raffreddat0/chessmaster/public/chessmaster-board.png

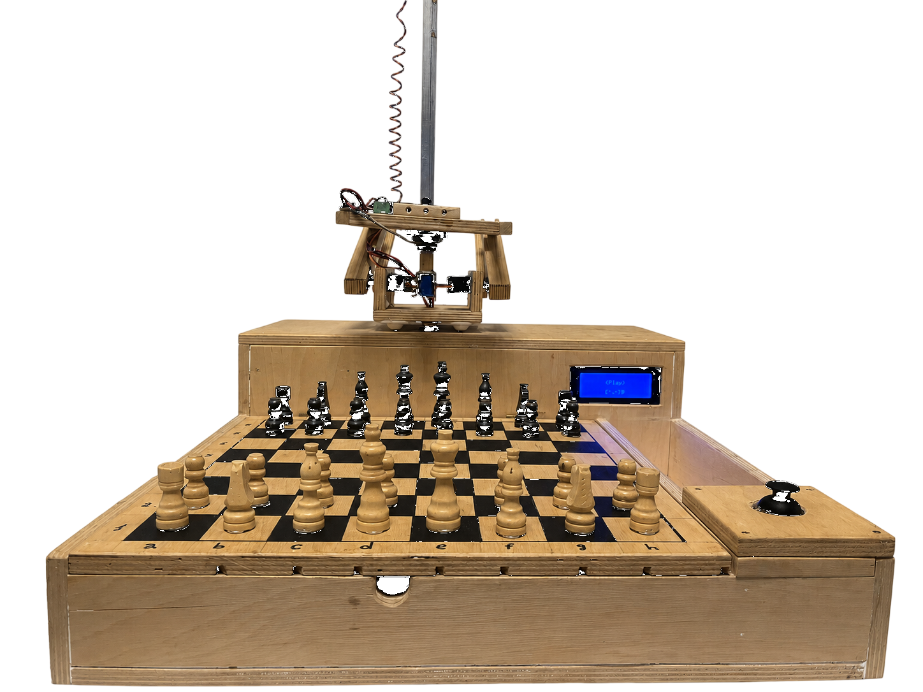
public/chessmaster-board.png
