raffreddat0/chessmaster/public/chessmaster-arm.png

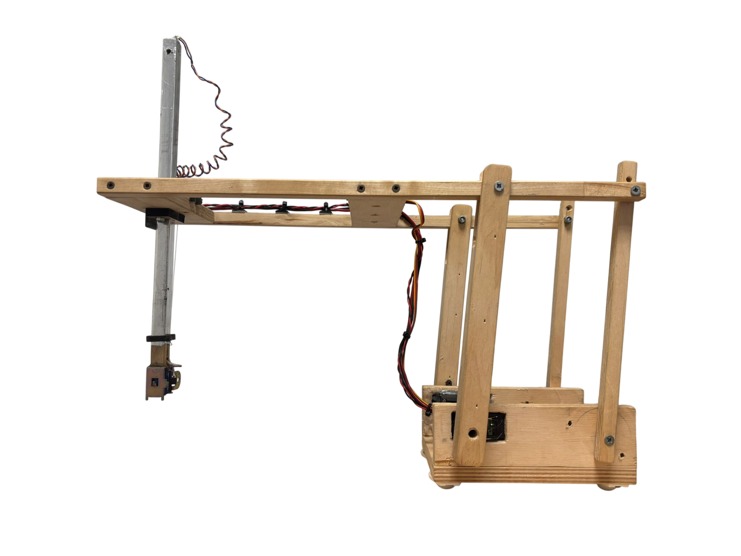
public/chessmaster-arm.png
