raffreddat0/chessmaster/public/frankie.png

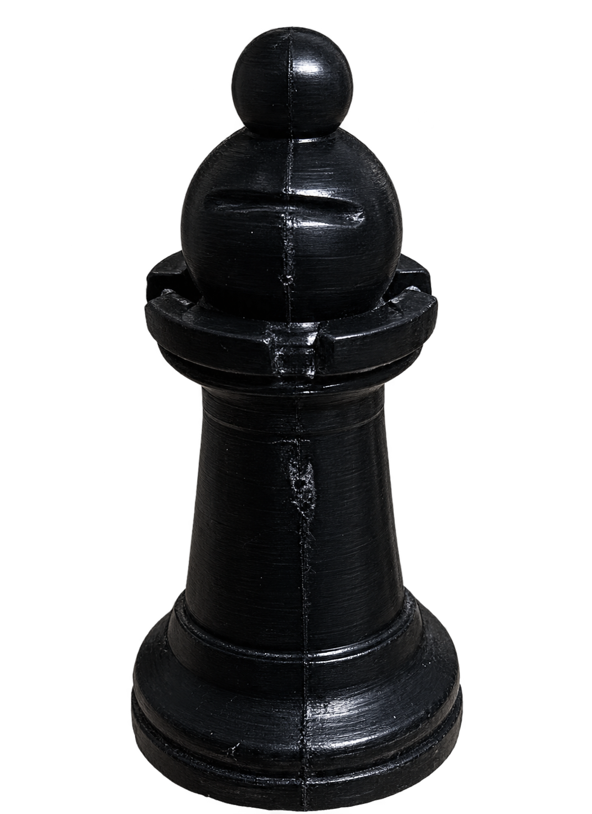
public/frankie.png
