raffreddat0/chessmaster/arduino/mega/mega.ino

#include "menu.h"

int M[cell][cell], M0[cell][cell];
char position[5] = "";
int moved[2] = {0, 0};
int invalid[2] = {-1, -1};
int t = 0;

void setup() {
  Serial.begin(9600);
  Serial1.begin(9600);
  lcdbegin();
  serbegin();

  for (int i = 0; i < cell; i++) {
    pinMode(cols[i], OUTPUT);
    pinMode(rows[i], INPUT_PULLUP);
  }

  for (int row = 0; row < cell; row++) {
    for (int col = 0; col < cell; col++) {
      for (int i = 0; i < cell; i++)
        digitalWrite(cols[i], LOW);

      digitalWrite(cols[col], HIGH);
      M[row][col] = M0[row][col] = digitalRead(rows[row]);
    }
  }
}

void loop() {
  int playing = lcdloop(M, t, position, invalid);
  serloop();

  if (ddlay(500)) {
    //Serial.print("\n\n\n");
    for (int row = 0; row < cell; row++) {
      for (int col = 0; col < cell; col++) {
        for (int i = 0; i < cell; i++)
          digitalWrite(cols[i], LOW);

        digitalWrite(cols[col], HIGH);
        M[row][col] = digitalRead(rows[row]);
        if (M[row][col] != M0[row][col] && M0[row][col] == 1 && t == 0) {
          position[0] = char('a' + col);
          position[1] = char('1' + 7 - row);
          position[2] = '\0';
          position[3] = '\0';
          position[4] = '\0';
          moved[0] = 1;
          moved[1] = 0;
        }

        if (M[row][col] != M0[row][col] && M0[row][col] == 0 && moved[0] == 1 && t == 0) {
          position[2] = char('a' + col);
          position[3] = char('1' + 7 - row);
          position[4] = '\0';
          moved[1] = 1;
        }

        M0[row][col] = M[row][col];
        //Serial.print(M[row][col]);
      }
      //Serial.print("\n");
    }
  }

  if (moved[0] == 1 && invalid[0] != -1 && invalid[1] != -1) {
    invalid[0] = -1;
    invalid[1] = -1;
  }

  if (moved[0] == 1 && moved[1] == 1) {
    if (playing == 1 && (position[0] != position[2] || position[1] != position[3]) && t == 0) {
      // Serial.println(String(position));
      Serial1.println(String("move ") + String(position));
    } else {
      strcpy(position, "");
    }

    moved[0] = 0;
    moved[1] = 0;
  }
}
