raffreddat0/chessmaster/arduino/mega/servo.h

#include <Servo.h>
#include "pins.h"

Servo servo1;
Servo servo2;
Servo servo3;
Servo servo4;

float dwn = 0;

struct Square {
  int turn;
  int move;
  int down;
};

extern Square S0 = {};
extern Square S[8][8] = {};

void serbegin() {
  Serial.begin(9600);

  pinMode(pinMagnet, LOW);
  pinMode(pinBreakOutput, OUTPUT);
  digitalWrite(pinBreakOutput, HIGH);
  pinMode(pinBreak, INPUT_PULLUP);

  servo1.detach();
  servo2.detach();
  servo3.detach();
  servo4.detach();

  servo3.attach(servoM1);
  servo4.attach(servoM2);
  servo3.write(0);
  servo4.write(180);

  servo1.attach(servoH);
  servo1.write(80);

  delay(200);
}

void turn(int degree) {
  servo1.attach(servoH);
  int prev = servo1.read();
  if (degree > prev)
    for (int angolo = prev; angolo <= degree; angolo++) {
      servo1.write(angolo);
      delay(15);
    }
  else
    for (int angolo = prev; angolo >= degree; angolo--) {
      servo1.write(angolo);
      delay(15);
    }
}

void move(int degree) {
  servo3.attach(servoM1);
  servo4.attach(servoM2);
  int prev = servo3.read();
  if (degree > prev) {
    for (int angolo = prev; angolo <= degree; angolo++) {
      servo3.write(angolo);
      servo4.write(180 - angolo);
      delay(20);
    }
  } else
    for (int angolo = prev; angolo >= degree; angolo--) {
      servo3.write(angolo);
      servo4.write(180 - angolo);
      delay(20);
    }
}

void up(int ms) {
  for (int i = 1; i < ms * 1.5 / 100 + 3; i++) {
    if (digitalRead(pinBreak)) {
      dwn = 0;
      return;
    }

    servo2.attach(servoUD);
    servo2.writeMicroseconds(0);
    delay(100);
    servo2.detach();
    delay(10);
  }

  dwn = (dwn - ms < 0 ? 0 : dwn - ms) / 100;
}

void down(int ms) {
  for (int i = 1; i < (ms / 100) + 1; i++) {
    servo2.attach(servoUD);
    servo2.writeMicroseconds(3000);
    delay(100);
    servo2.detach();
    delay(10);
  }

  dwn += ms / 100;
}

void reset() {
  if (dwn > 0)
    up(dwn * 100);
  move(0);
  turn(80);
  delay(200);
}

void movePiece(String position, int magnet = 0) {
  char lettera = position.charAt(0);
  int colonna = position.substring(1).toInt();

  int rigaIndex = 7 - (colonna - 1);
  int colIndex = lettera - 'a';

  if (rigaIndex >= 0 && rigaIndex < 8 && colIndex >= 0 && colIndex < 8) {
    int h = S[rigaIndex][colIndex].turn;
    int v = S[rigaIndex][colIndex].move;
    int d = S[rigaIndex][colIndex].down;

    reset();
    turn(h < 0 ? 0 : h);
    move(v < 0 ? 0 : v);
    down(d < 0 ? 0 : (d * 100));
    delay(250);
    pinMode(pinMagnet, magnet);
    delay(250);
    reset();
  }
}

void eat() {
  reset();
  turn(S0.turn < 0 ? 0 : S0.turn);
  move(S0.move < 0 ? 0 : S0.move);
  down(S0.down < 0 ? 0 : (S0.down * 100));
  delay(250);
  pinMode(pinMagnet, 0);
  delay(250);
  reset();
}

void serloop() {
  if (Serial.available()) {
    String input = Serial.readStringUntil('\n');
    input.trim();
    Serial.println(input);

    if (input == "on")
      pinMode(pinMagnet, HIGH);
    else if (input == "off")
      pinMode(pinMagnet, LOW);
    else if (input == "reset")
      reset();
    else if (input.startsWith("eat")) {
      eat();
    } else if (input.startsWith("up")) {
      int delayTime = input.substring(3).toInt();
      up(delayTime);
    } else if (input.startsWith("down")) {
      int delayTime = input.substring(4).toInt();
      down(delayTime);
    } else if (input.startsWith("turn")) {
      int degree = input.substring(5).toInt();
      turn(degree);
    } else if (input.startsWith("move")) {
      int degree = input.substring(5).toInt();
      move(degree);
    } else {
      movePiece(input, 1);
      if (input.length() > 2)
        movePiece(input.substring(2), 0);
    }
  }
}
